SukkoPera/MyTrackr/pcb/MyTrackr.png

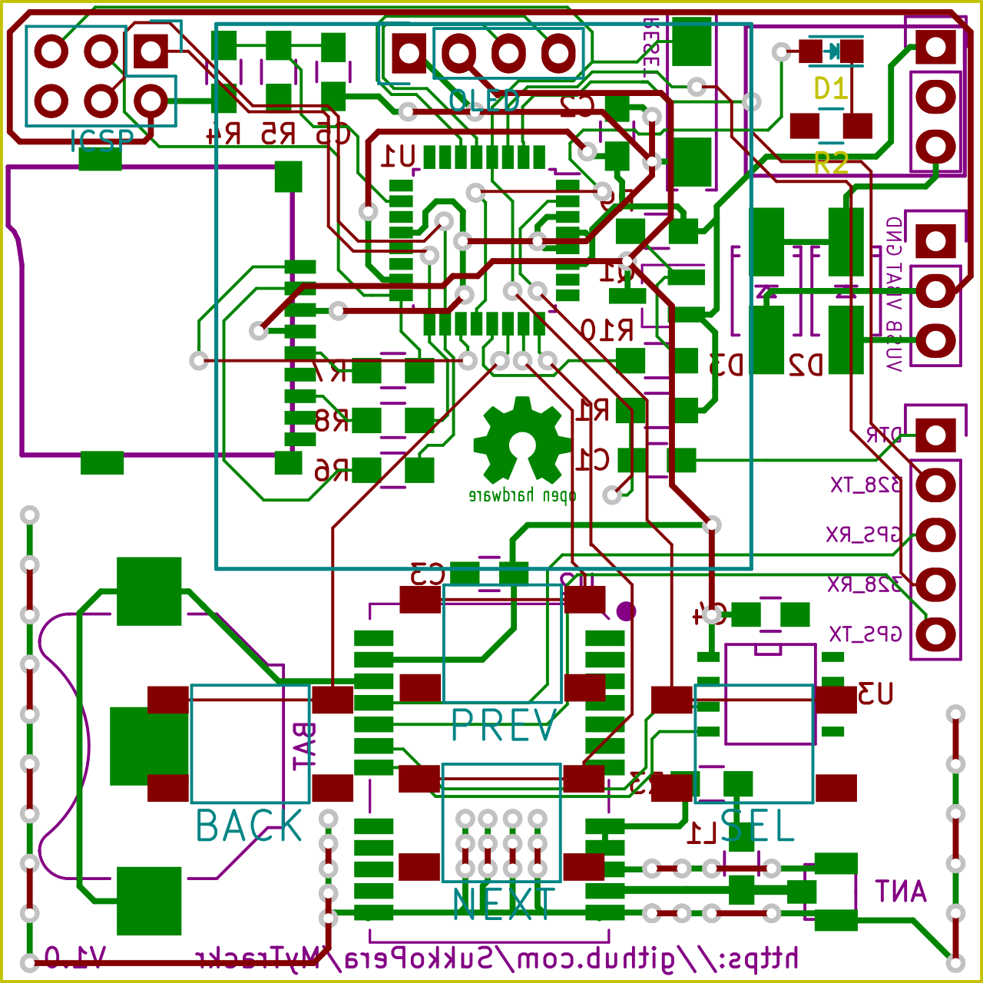
pcb/MyTrackr.png
