SukkoPera/MyTrackr/pcb/MyTrackr.pdf

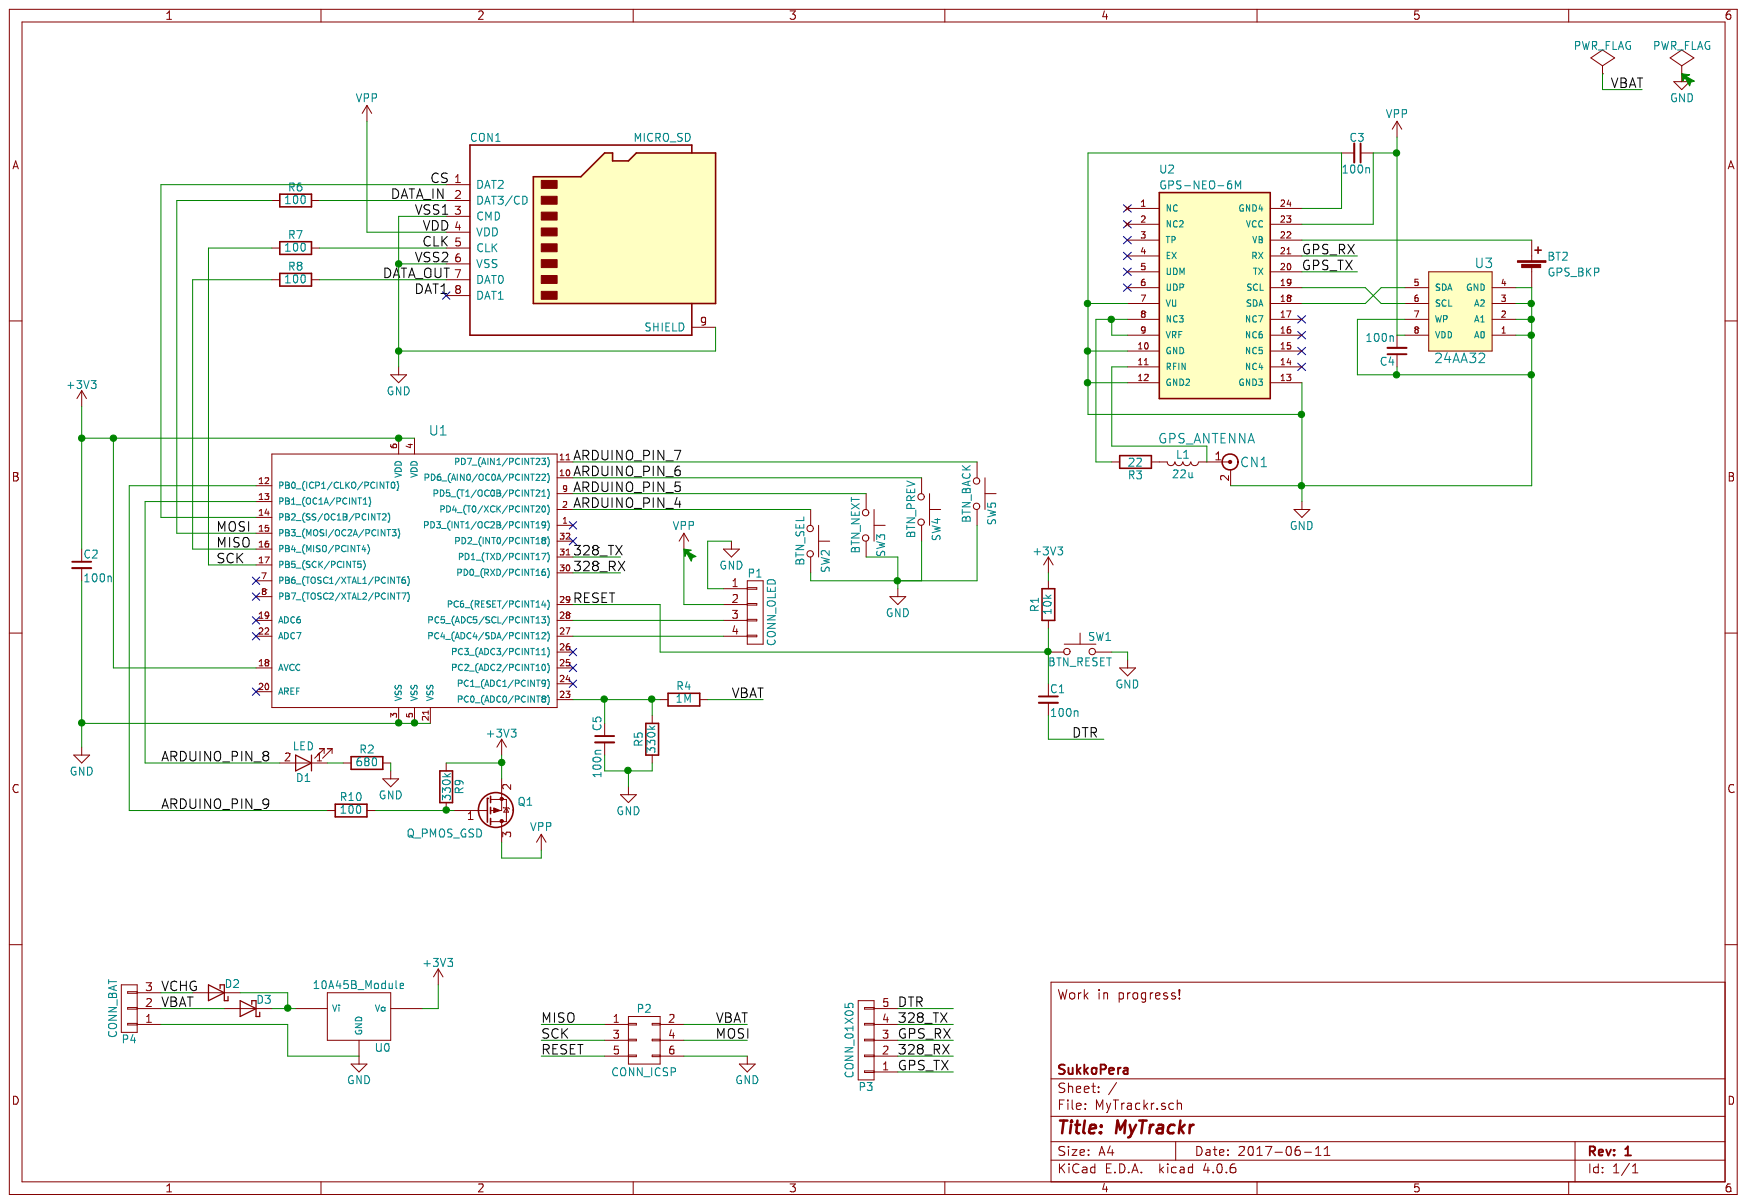
[picture p2: page 1]
