SukkoPera/MyTrackr/(list of files, drawings)

Other design files:
playground/ArdWinVaders/ArdWinVaders.fzz
