SukkoPera/MyTrackr/pcb/KiCad/MyTrackr.kicad_pcb

## KiCad design pcb/KiCad/MyTrackr.kicad_pcb (2017-09-08)

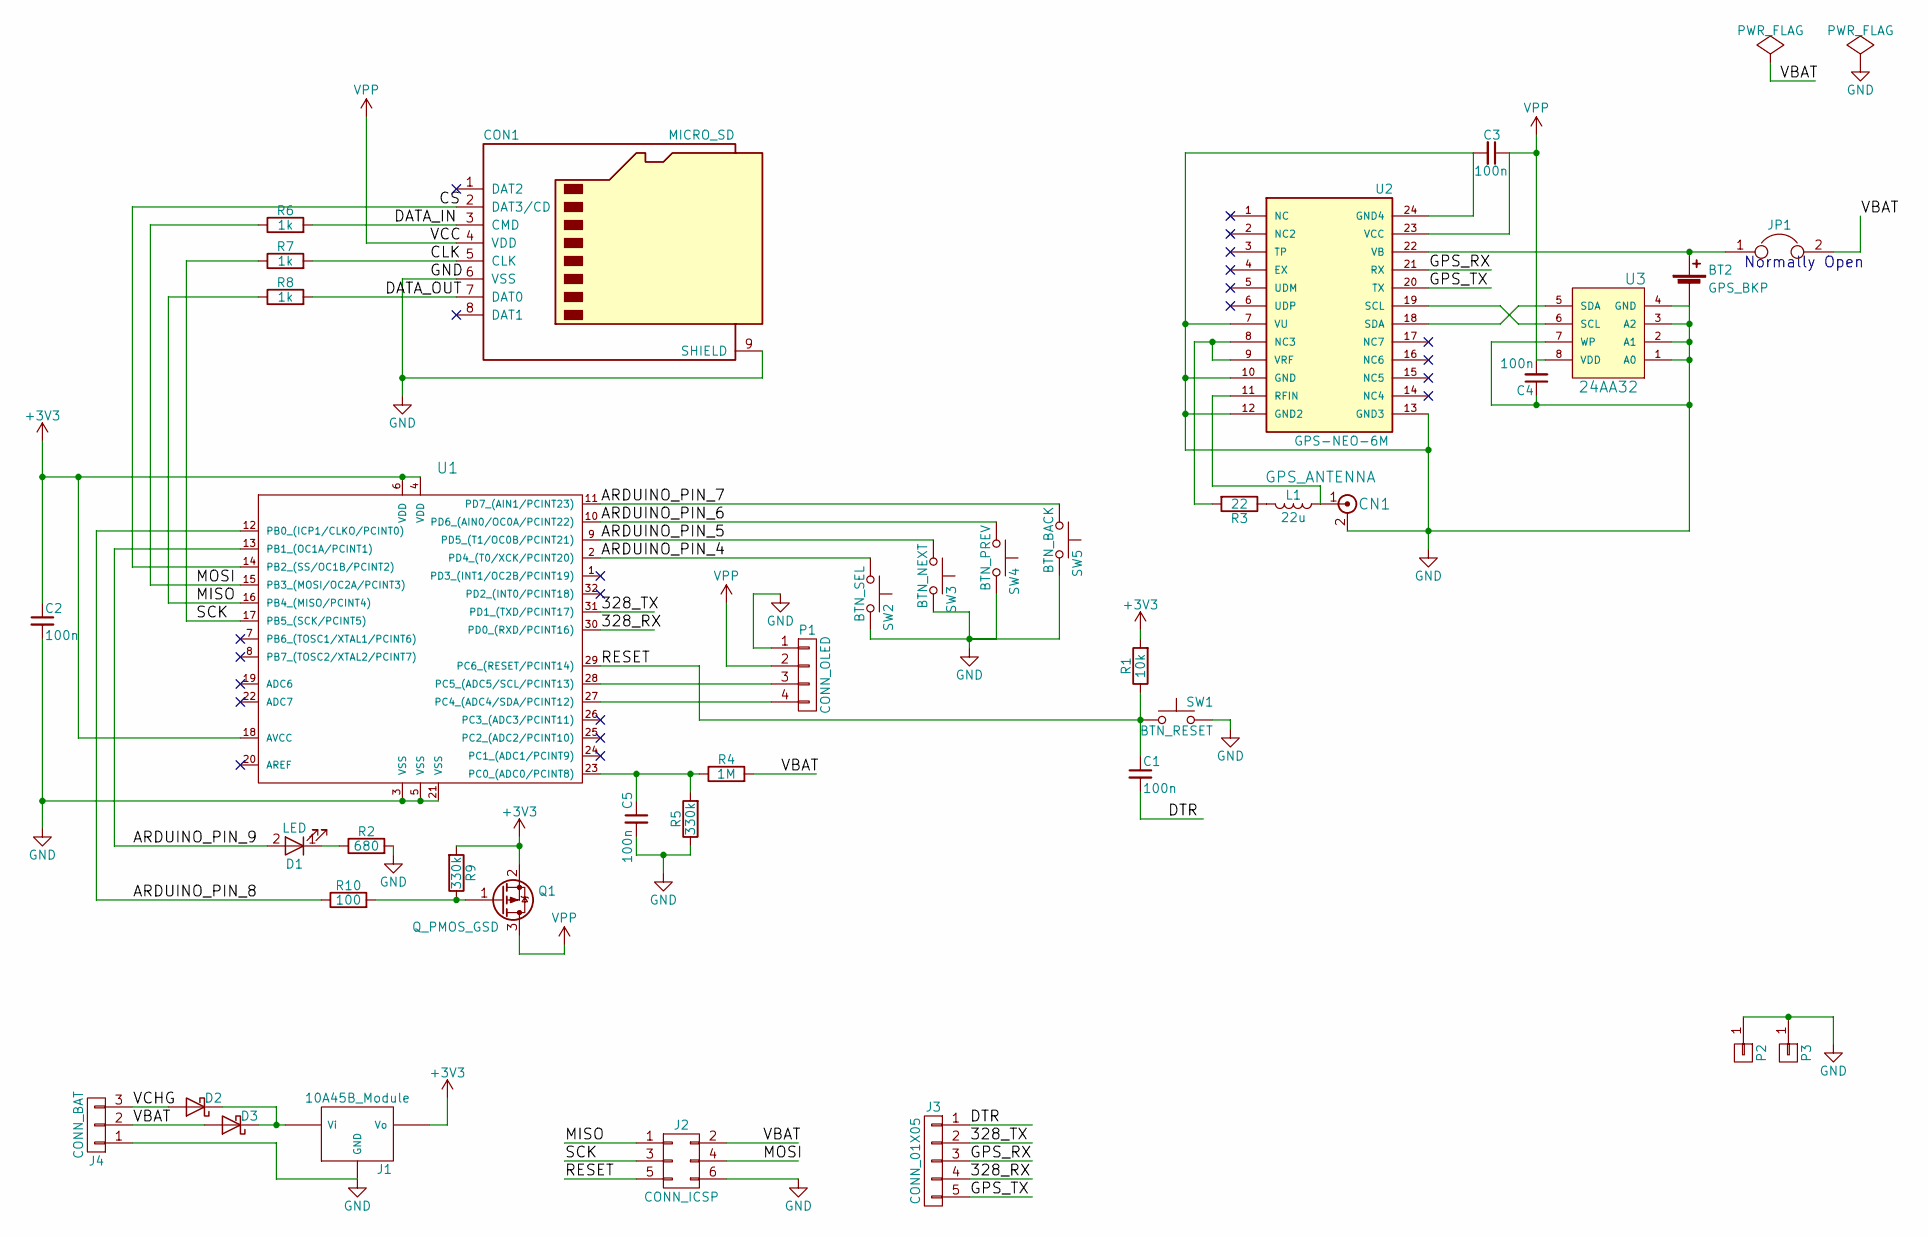
[picture p3: schematic MyTrackr.sch]

Parts:
BT2: GPS_BKP; Keystone_3000_1x12mm-CoinCell
C1, C2, C3, C4, C5: 100n; C_0805_HandSoldering
CN1: GPS_ANTENNA; CONN-RF-UFL
CON1: MICRO_SD; GCT-MEM2055-00-190-01-A
D1: LED; LED_0805
D2, D3: D_Schottky; SMA_Handsoldering
J1: 10A45B_Module; Pin_Header_Straight_1x03
J2: CONN_ICSP; Pin_Header_Straight_2x03
J3: CONN_01X05; Pin_Header_Straight_1x05
J4: CONN_BAT; Pin_Header_Straight_1x03
JP1: NO; R_0805_HandSoldering
L1: 22u; R_0805_HandSoldering
P1: CONN_OLED; Pin_Header_Straight_1x04
P2, P3: CONN_01X01; Screw_Hole_Plated_2mm
Q1: Q_PMOS_GSD; SOT-23_Handsoldering
R1: 10k; R_0805_HandSoldering
R2: 680; R_0805_HandSoldering
R3: 22; R_0805_HandSoldering
R4: 1M; R_0805_HandSoldering
R5, R9: 330k; R_0805_HandSoldering
R6, R7, R8: 1k; R_0805_HandSoldering
R10: 100; R_0805_HandSoldering
SW1: BTN_RESET; SW_SPST_REED_CT05-XXXX-J1
SW2: BTN_SEL; SW_TACT_SMD
SW3: BTN_NEXT; SW_TACT_SMD
SW4: BTN_PREV; SW_TACT_SMD
SW5: BTN_BACK; SW_TACT_SMD
U1: ATMEGA48_88_168_328P-32SMD; LQFP-32_7x7mm_Pitch0.8mm
U2: GPS-NEO-6M; GPS24P-SMD-1.1-16X12.2MM
U3: 24AA32; tssop-8

Connections:
+3V3: C2.1, J1.1 (Vo), Q1.2 (S), R1.2, R9.2, U1.4 (VDD), U1.6 (VDD), U1.18 (AVCC)
/328_RX: J3.4, U1.30 (PD0_(RXD/PCINT16))
/328_TX: J3.2, U1.31 (PD1_(TXD/PCINT17))
/ARDUINO_PIN_4: SW2.1, U1.2 (PD4_(T0/XCK/PCINT20))
/ARDUINO_PIN_5: SW3.1, U1.9 (PD5_(T1/OC0B/PCINT21))
/ARDUINO_PIN_6: SW4.1, U1.10 (PD6_(AIN0/OC0A/PCINT22))
/ARDUINO_PIN_7: SW5.1, U1.11 (PD7_(AIN1/PCINT23))
/ARDUINO_PIN_8: R10.1, U1.12 (PB0_(ICP1/CLKO/PCINT0))
/ARDUINO_PIN_9: D1.2 (A), U1.13 (PB1_(OC1A/PCINT1))
/CLK: CON1.5 (CLK), R7.2
/CS: CON1.2 (DAT3/CD), U1.14 (PB2_(SS/OC1B/PCINT2))
/DATA_IN: CON1.3 (CMD), R6.2
/DATA_OUT: CON1.7 (DAT0), R8.2
/DTR: C1.2, J3.1
/GPS_RX: J3.3, U2.21 (RX)
/GPS_TX: J3.5, U2.20 (TX)
/MISO: J2.1, R8.1, U1.16 (PB4_(MISO/PCINT4))
/MOSI: J2.4, R6.1, U1.15 (PB3_(MOSI/OC2A/PCINT3))
/RESET: C1.1, J2.5, R1.1, SW1.1, U1.29 (PC6_(RESET/PCINT14))
/SCK: J2.3, R7.1, U1.17 (PB5_(SCK/PCINT5))
/VBAT: D3.2 (A), J2.2, J4.2, JP1.2, R4.2
/VCHG: D2.2 (A), J4.3
GND: BT2.2 (-), C2.2, C3.2, C4.1, C5.2, CN1.2, CON1.6 (VSS), CON1.9 (SHIELD), J1.2 (GND), J2.6, J4.1, P1.1, P2.1, P3.1, R2.2, R5.1, SW1.2, SW2.2, SW3.2, SW4.2, SW5.2, U1.3 (VSS), U1.5 (VSS), U1.21 (VSS), U2.7 (VU), U2.10 (GND), U2.12 (GND2), U2.13 (GND3), U2.24 (GND4), U3.1 (A0), U3.2 (A1), U3.3 (A2), U3.4 (GND), U3.7 (WP)
unnamed: BT2.1 (+), JP1.1, U2.22 (VB)
unnamed: C5.1, R4.1, R5.2, U1.23 (PC0_(ADC0/PCINT8))
unnamed: CN1.1, L1.1, U2.11 (RFIN)
unnamed: D1.1 (K), R2.1
unnamed: D2.1 (K), D3.1 (K), J1.3 (Vi)
unnamed: L1.2, R3.1
unnamed: P1.3, U1.28 (PC5_(ADC5/SCL/PCINT13))
unnamed: P1.4, U1.27 (PC4_(ADC4/SDA/PCINT12))
unnamed: Q1.1 (G), R9.1, R10.2
unnamed: R3.2, U2.8 (NC3), U2.9 (VRF)
unnamed: U2.18 (SDA), U3.5 (SDA)
unnamed: U2.19 (SCL), U3.6 (SCL)
VPP: C3.1, C4.2, CON1.4 (VDD), P1.2, Q1.3 (D), U2.23 (VCC), U3.8 (VDD)

Notes on the sheet:
Normally Open

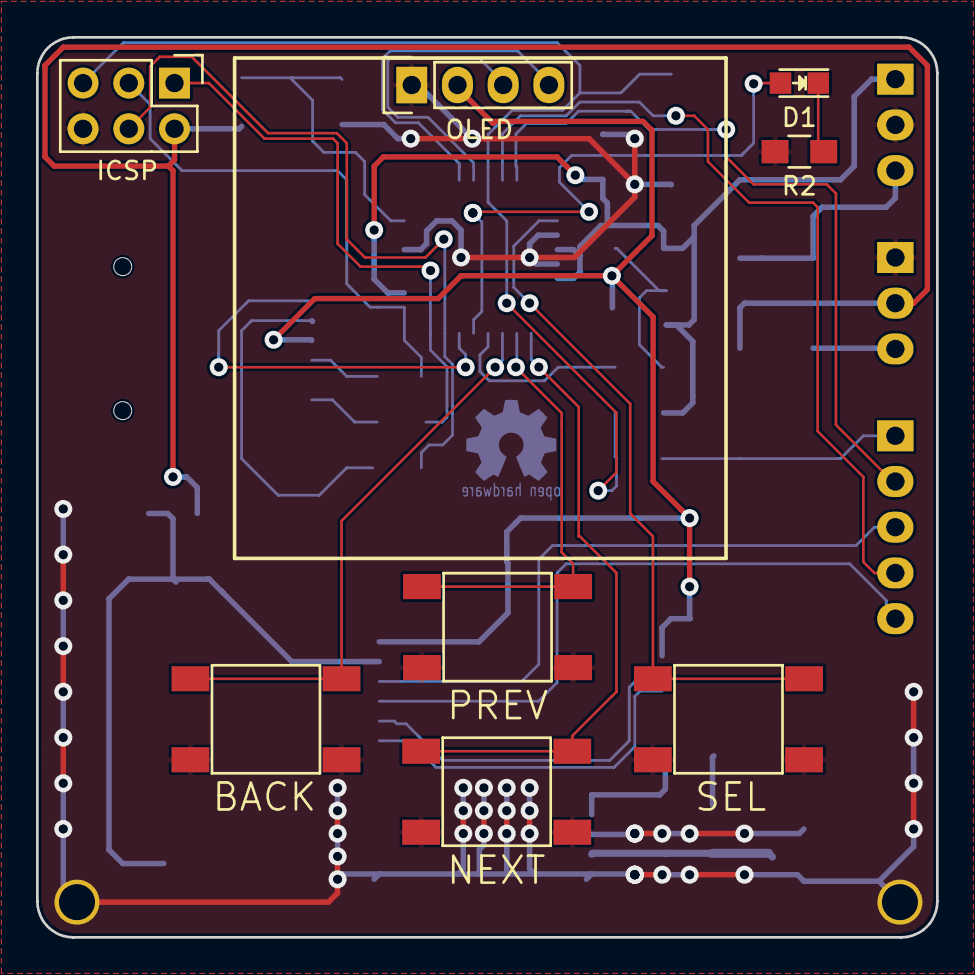
[picture p4: board MyTrackr.kicad_pcb from above]

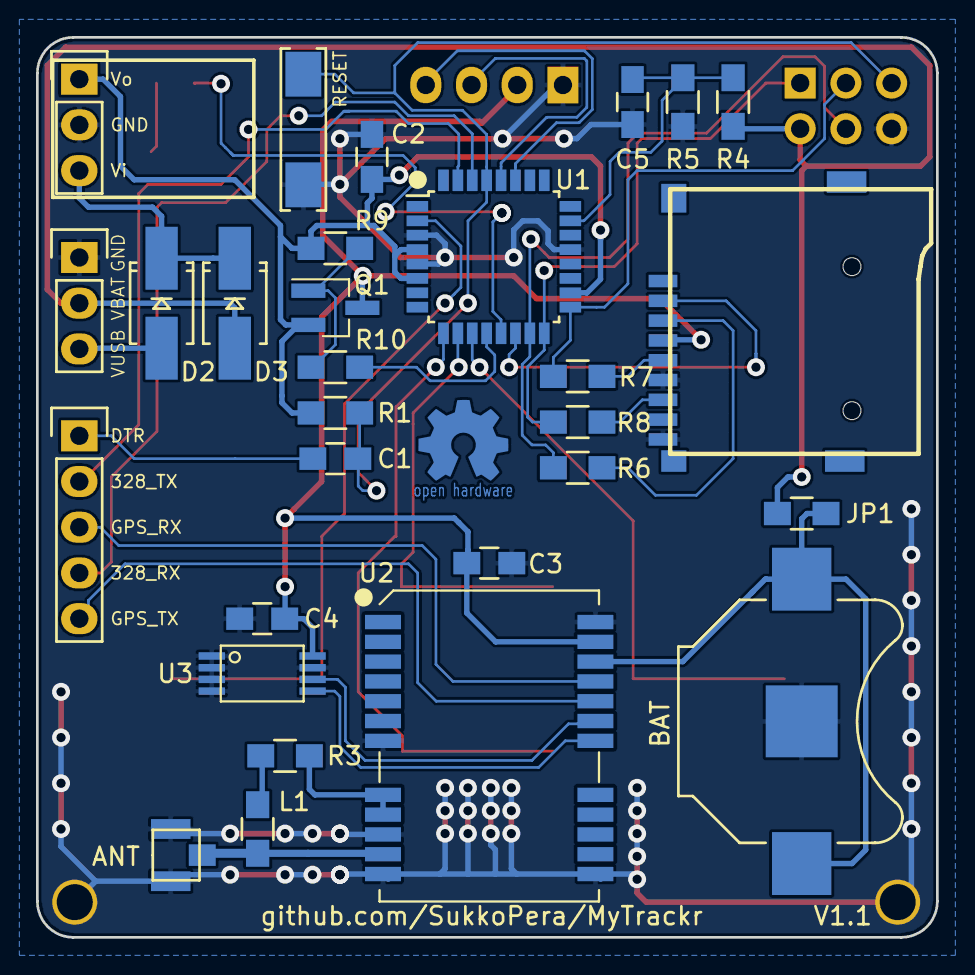
[picture p5: board MyTrackr.kicad_pcb from below]

Board: 2 copper layers, 50.0 x 50.0 mm, 39 parts (29 on the bottom side), 36 nets.
