SukkoPera/MyTrackr/menu.h

#include "MenuHandler.h"

MenuHandler menuHandler;

class SwitcherMenuItem: public StaticMenuItem {
private:
	Menu menu;

public:
	SwitcherMenuItem (PGM_P _name, const Menu& _m): StaticMenuItem (_name), menu (_m) {
	}

	void activate (void) override {
		menuHandler.setCur (menu);
	}
};

/******************************************************************************/

// Forward declarations
extern MenuItem * const topMenu[] PROGMEM, * const subMenuLogOpts[] PROGMEM, * const subMenuTimeOpts[] PROGMEM;

// Item to get back to main menu
const char mlBack[] PROGMEM = "Back";
SwitcherMenuItem lbtop (mlBack, topMenu);


/*******************************************************************************
 * Log Options Menu
 ******************************************************************************/

SwitcherMenuItem lb (mlBack, subMenuLogOpts);

class MenuItemLogFreq: public StaticMenuItem {
private:
	byte freq;

public:
	MenuItemLogFreq (PGM_P name, byte f): StaticMenuItem (name), freq (f) {
	}

	void activate () override {
		options.logFreq = freq;

		DPRINT (F("Log Frequency is now "));
		DPRINT (options.logFreq);
		DPRINTLN (F(" seconds"));

		lb.activate ();
	}

	bool isSelected (void) override {
		return options.logFreq == freq;
	}
};

#ifdef ENABLE_DISTANCE_MENU
class MenuItemLogDist: public StaticMenuItem {
private:
	int dist;

public:
	MenuItemLogDist (PGM_P name, int d): StaticMenuItem (name), dist (d) {
	}

	void activate () override {
		options.logDist = dist;

		DPRINT (F("Log Distance is now "));
		DPRINT (options.logDist);
		DPRINTLN (F(" meters"));

		lb.activate ();
	}

	bool isSelected (void) override {
		return options.logDist == dist;
	}
};
#endif

#ifdef ENABLE_ROTATION_MENU
class MenuItemLogRot: public StaticMenuItem {
private:
	LogRotation rot;

public:
	MenuItemLogRot (PGM_P name, LogRotation r): StaticMenuItem (name), rot (r) {
	}

	void activate () override {
		options.logRot = rot;

		DPRINT (F("Log Rotation is now "));
		DPRINTLN (options.logRot);

		lb.activate ();
	}

	bool isSelected (void) override {
		return options.logRot == rot;
	}
};
#endif

const char mlf1[] PROGMEM = "1 second";
MenuItemLogFreq lf1 (mlf1, 1);
const char mlf5[] PROGMEM = "5 seconds";
MenuItemLogFreq lf5 (mlf5, 5);
const char mlf10[] PROGMEM = "10 seconds";
MenuItemLogFreq lf10 (mlf10, 10);
const char mlf30[] PROGMEM = "30 seconds";
MenuItemLogFreq lf30 (mlf30, 30);
const char mlf60[] PROGMEM = "1 minute";
MenuItemLogFreq lf60 (mlf60, 60);
MenuItem * const subMenuLogFreq[] PROGMEM = {&lf1, &lf5, &lf10, &lf30, &lf60, &lb, NULL};

const char mlOff[] PROGMEM = "Off";
#ifdef ENABLE_DISTANCE_MENU
MenuItemLogDist ldOff (mlOff, 0);
const char ml10[] PROGMEM = "10 m";
MenuItemLogDist ld10 (ml10, 10);
const char ml100[] PROGMEM = "100 m";
MenuItemLogDist ld100 (ml100, 100);
const char ml250[] PROGMEM = "250 m";
MenuItemLogDist ld250 (ml250, 250);
const char ml1000[] PROGMEM = "1 km";
MenuItemLogDist ld1000 (ml1000, 1000);
MenuItem * const subMenuLogDist[] PROGMEM = {&ldOff, &ld10, &ld100, &ld250, &ld1000, &lb, NULL};
#endif

#ifdef ENABLE_ROTATION_MENU
MenuItemLogRot lrOff (mlOff, LOGROT_OFF);
const char mlH[] PROGMEM = "Hourly";
MenuItemLogRot lrH (mlH, LOGROT_HOURLY);
const char mlD[] PROGMEM = "Daily";
MenuItemLogRot lrD (mlD, LOGROT_DAILY);
const char mlW[] PROGMEM = "Weekly";
MenuItemLogRot lrW (mlW, LOGROT_WEEKLY);
const char mlM[] PROGMEM = "Monthly";
MenuItemLogRot lrM (mlM, LOGROT_MONTHLY);
MenuItem * const subMenuLogRot[] PROGMEM = {&lrOff, &lrH, &lrD, &lrW, &lrM, &lb, NULL};
#endif

const char mlFreq[] PROGMEM = "Frequency";
SwitcherMenuItem loFreq (mlFreq, subMenuLogFreq);
#ifdef ENABLE_DISTANCE_MENU
const char mlDist[] PROGMEM = "Distance";
SwitcherMenuItem loDist (mlDist, subMenuLogDist);
#endif
#ifdef ENABLE_ROTATION_MENU
const char mlRot[] PROGMEM = "Rotation";
SwitcherMenuItem loRot (mlRot, subMenuLogRot);
#endif
MenuItem * const subMenuLogOpts[] PROGMEM = {&loFreq,
#ifdef ENABLE_DISTANCE_MENU
	&loDist,
#endif
#ifdef ENABLE_ROTATION_MENU
	&loRot,
#endif
	&lbtop, NULL};


/*******************************************************************************
 * Time Options Menu
 ******************************************************************************/

SwitcherMenuItem ltb (mlBack, subMenuTimeOpts);

class MenuItemTimeOffset: public StaticMenuItem {
private:
	int8_t offset;

public:
	MenuItemTimeOffset (PGM_P name, int8_t o): StaticMenuItem (name), offset (o) {
	}

	void activate () override {
		options.utcOffset = offset;

		DPRINT (F("UTC offset is now "));
		DPRINT (options.utcOffset);
		DPRINTLN (F(" hours"));

		ltb.activate ();
	}

	bool isSelected (void) override {
		return options.utcOffset == offset;
	}
};

class MenuItemTimeDst: public StaticMenuItem {
private:
	DaylightSavingMode mode;

public:
	MenuItemTimeDst (PGM_P name, DaylightSavingMode m): StaticMenuItem (name), mode (m) {
	}

	void activate () override {
		options.dstMode = mode;

		DPRINT (F("DST mode is now "));
		DPRINTLN (options.dstMode);

		ltb.activate ();
	}

	bool isSelected (void) override {
		return options.dstMode == mode;
	}
};

const char mlAuto[] PROGMEM = "Auto";
MenuItemTimeDst da (mlAuto, DST_AUTO);
const char mlOn[] PROGMEM = "On";
MenuItemTimeDst don (mlOn, DST_ON);
MenuItemTimeDst doff (mlOff, DST_OFF);
MenuItem * const subMenuDstMode[] PROGMEM = {&da, &don, &doff, &ltb, NULL};

const char mlOm12[] PROGMEM = "-12";
MenuItemTimeOffset om12 (mlOm12, -12);
const char mlOm11[] PROGMEM = "-11";
MenuItemTimeOffset om11 (mlOm11, -11);
const char mlOm10[] PROGMEM = "-10";
MenuItemTimeOffset om10 (mlOm10, -10);
const char mlOm9[] PROGMEM = "-9";
MenuItemTimeOffset om9 (mlOm9, -9);
const char mlOm8[] PROGMEM = "-8";
MenuItemTimeOffset om8 (mlOm8, -8);
const char mlOm7[] PROGMEM = "-7";
MenuItemTimeOffset om7 (mlOm7, -7);
const char mlOm6[] PROGMEM = "-6";
MenuItemTimeOffset om6 (mlOm6, -6);
const char mlOm5[] PROGMEM = "-5";
MenuItemTimeOffset om5 (mlOm5, -5);
const char mlOm4[] PROGMEM = "-4";
MenuItemTimeOffset om4 (mlOm4, -4);
const char mlOm3[] PROGMEM = "-3";
MenuItemTimeOffset om3 (mlOm3, -3);
const char mlOm2[] PROGMEM = "-2";
MenuItemTimeOffset om2 (mlOm2, -2);
const char mlOm1[] PROGMEM = "-1";
MenuItemTimeOffset om1 (mlOm1, -1);
const char mlO0[] PROGMEM = "0";
MenuItemTimeOffset o0 (mlO0, 0);
const char mlOp1[] PROGMEM = "+1";
MenuItemTimeOffset op1 (mlOp1, +1);
const char mlOp2[] PROGMEM = "+2";
MenuItemTimeOffset op2 (mlOp2, +2);
const char mlOp3[] PROGMEM = "+3";
MenuItemTimeOffset op3 (mlOp3, +3);
const char mlOp4[] PROGMEM = "+4";
MenuItemTimeOffset op4 (mlOp4, +4);
const char mlOp5[] PROGMEM = "+5";
MenuItemTimeOffset op5 (mlOp5, +5);
const char mlOp6[] PROGMEM = "+6";
MenuItemTimeOffset op6 (mlOp6, +6);
const char mlOp7[] PROGMEM = "+7";
MenuItemTimeOffset op7 (mlOp7, +7);
const char mlOp8[] PROGMEM = "+8";
MenuItemTimeOffset op8 (mlOp8, +8);
const char mlOp9[] PROGMEM = "+9";
MenuItemTimeOffset op9 (mlOp9, +9);
const char mlOp10[] PROGMEM = "+10";
MenuItemTimeOffset op10 (mlOp10, +10);
const char mlOp11[] PROGMEM = "+11";
MenuItemTimeOffset op11 (mlOp11, +11);
const char mlOp12[] PROGMEM = "+12";
MenuItemTimeOffset op12 (mlOp12, +12);
MenuItem * const subMenuUtcOffset[] PROGMEM = {
	&om12, &om11, &om10, &om9, &om8, &om7, &om6, &om5, &om4, &om3, &om2, &om1,
	&o0,
	&op1, &op2, &op3, &op4, &op5, &op6, &op7, &op8, &op9, &op10, &op11, &op12,
	&ltb,
	NULL
};

const char mlUtcOffset[] PROGMEM = "UTC Offset";
SwitcherMenuItem toOff (mlUtcOffset, subMenuUtcOffset);
const char mlDst[] PROGMEM = "Daylight Saving";
SwitcherMenuItem toDst (mlDst, subMenuDstMode);
MenuItem * const subMenuTimeOpts[] PROGMEM = {&toOff, &toDst, &lbtop, NULL};


/*******************************************************************************
 * Backlight Timeout Menu
 ******************************************************************************/

#ifdef ENABLE_BACKLIGHT_MENU
class MenuItemBacklight: public StaticMenuItem {
private:
	byte interval;

public:
	MenuItemBacklight (PGM_P name, byte s): StaticMenuItem (name), interval (s) {
	}

	void activate () override {
		options.backlightTimeout = interval;

		DPRINT (F("Backlight Timeout is now "));
		DPRINT (options.backlightTimeout);
		DPRINTLN (F(" seconds"));

		lbtop.activate ();
	}

	bool isSelected (void) override {
		return options.backlightTimeout == interval;
	}
};

const char mblOn[] PROGMEM = "Always On";
MenuItemBacklight blOn (mblOn, 0);
MenuItemBacklight bl5 (mlf5, 5);
const char mbl15[] PROGMEM = "15 seconds";
MenuItemBacklight bl15 (mbl15, 15);
MenuItemBacklight bl30 (mlf30, 30);
MenuItemBacklight bl60 (mlf60, 60);
MenuItem * const subMenuBacklight[] PROGMEM = {&blOn, &bl5, &bl15, &bl30, &bl60, &lbtop, NULL};
#endif


/*******************************************************************************
 * Main Menu
 ******************************************************************************/

class StartStopMenuItem: public MenuItem {
public:
	FlashString getName (void) const override {
		if (logEnabled)
			return F("Stop");
		else
			return F("Start");
	}

	void activate (void) override {
		if (!logEnabled && sdAvailable) {
			logEnabled = true;
		} else {
			logEnabled = false;
		}

		DPRINT (F("Logging is now "));
		DPRINTLN (logEnabled ? F("ON") : F("OFF"));
	}
};

class ExitMenuItem: public StaticMenuItem {
public:
	ExitMenuItem (): StaticMenuItem (PSTR("Exit")) {
	}

	void activate (void) override {
		// Save data to EEPROM
		EEPROM.put (EEPROM_DATA_OFFSET, options);
		EEPROM.put (EEPROM_DATA_OFFSET + sizeof (options), EEPROM_GOOD_SIGNATURE);
		menuHandler.hide ();
	}
};

#ifdef ENABLE_SOFT_POWEROFF
class PowerOffMenuItem: public StaticMenuItem {
public:
	PowerOffMenuItem (): StaticMenuItem (PSTR("Power Off")) {
	}

	void activate (void) override {
		powerOff ();
	}
};
#endif

StartStopMenuItem ss;
const char mlLogOpts[] PROGMEM = "Logging";
SwitcherMenuItem lo (mlLogOpts, subMenuLogOpts);
const char mlTimeOpts[] PROGMEM = "Time";
SwitcherMenuItem to (mlTimeOpts, subMenuTimeOpts);
#ifdef ENABLE_BACKLIGHT_MENU
const char mlBl[] PROGMEM = "Backlight";
SwitcherMenuItem bl (mlBl, subMenuBacklight);
#endif
ExitMenuItem ex;
#ifdef ENABLE_SOFT_POWEROFF
PowerOffMenuItem miPowerOff;
#endif
MenuItem * const topMenu[] PROGMEM = {&ss, &lo, &to,
#ifdef ENABLE_BACKLIGHT_MENU
	&bl,
#endif
#ifdef ENABLE_SOFT_POWEROFF
	&miPowerOff,
#endif
	&ex,
	NULL
};
