SukkoPera/MyTrackr/icons.h

// Height of header space
#define HEADER_HEIGHT 16

#define sat_width 16
#define sat_height 16
const unsigned char sat_bits[] PROGMEM = {
	0x08, 0x00, 0x14, 0x00, 0x22, 0x00, 0x41, 0x00, 0x82, 0x02, 0x84, 0x07,
	0xc8, 0x0f, 0xf0, 0x07, 0xe0, 0x0f, 0xf0, 0x13, 0xe0, 0x21, 0x40, 0x41,
	0x00, 0x82, 0x00, 0x44, 0x00, 0x28, 0x00, 0x10
};

#define microsd_width 16
#define microsd_height 16
const unsigned char microsd_bits[] PROGMEM = {
	0x00, 0x00, 0x00, 0x00, 0xf0, 0x1f, 0x50, 0x15, 0x50, 0x15, 0x50, 0x15,
	0xf0, 0x1f, 0xf0, 0x1f, 0xf8, 0x1f, 0xf8, 0x1f, 0xf8, 0x1f, 0xf8, 0x1f,
	0xf8, 0x1f, 0xf8, 0x1f, 0x00, 0x00, 0x00, 0x00
};

#define padlock_width 16
#define padlock_height 16
const unsigned char padlock_bits[] PROGMEM = {
   0xc0, 0x03, 0x60, 0x06, 0x30, 0x0c, 0x10, 0x08, 0x10, 0x08, 0x10, 0x08,
   0xf8, 0x1f, 0x0c, 0x30, 0x04, 0x20, 0xc4, 0x23, 0xc4, 0x23, 0x84, 0x21,
   0x84, 0x21, 0x04, 0x20, 0x0c, 0x30, 0xf8, 0x1f
};


// Battery icon size (this is drawn by hand)
#define BAT_WIDTH 16
#define BAT_HEIGHT 8
#define BAT_TIP 2
