SukkoPera/MyTrackr/(commit log)

2016-06-12 Blink sat & SD icon for relevant failures
    [MyTracker.ino]
2016-06-13 Fix altitude & some source reorganization
    [CSVWriter.cpp, CSVWriter.h, MyTracker.ino, config.h, debug.h]
2016-06-16 Fix trailing CR in log header with SD disabled
    [CSVWriter.cpp]
2016-06-19 Simplify key handling. Also support a PREV button, if available.
2016-06-25 Only consider fix valid if number of sats > 0
    [MyTracker.ino]
2016-07-10 Measure and display battery level
2016-10-09 Turn screen off to save power
2016-10-09 Revamp battery charge handling Work in progress...
    [battery.csv, logbat.csv, logbat5.csv]
2016-10-09 Remove useless battery logs
    [logbat.csv, logbat5.csv]
2017-05-07 Add "Alive LED"
2017-05-07 Reset current menu item when menu is opened
    [MenuHandler.h]
2017-05-08 Implement $GPGLL and fix checksum calculation
    [sim.py]
2017-05-08 Compile fix for when both ENABLE_SD_FATLIB and ENABLE_SD_FAT16 are disabled
    [CSVWriter.cpp]
2017-05-17 Add first version of PCB
2017-05-17 Add voltage divider for battery
2017-05-18 Add resistors on SPI lines, add cap on A0, add pull-down on MOSFET
2017-06-11 Update schematics
2017-06-11 Fix MOSFET orientation, add resistor on gate and change pull-up value
2017-08-03 Add prototype PCB design files
    [MyTrackr-B.Cu.gbr, MyTrackr-B.Mask.gbr, MyTrackr-B.SilkS.gbr, MyTrackr-Edge.Cuts.gbr, MyTrackr-F.Cu.gbr, MyTrackr-F.Mask.gbr, MyTrackr-F.SilkS.gbr, MyTrackr-NPTH.drl]
2017-09-06 Corrections and tweaks after first prototype
    [MyTrackr.kicad_pcb, MyTrackr.sch]
2017-09-06 Expand zones
    [MyTrackr.kicad_pcb]
2017-09-08 Add screw holes, smooth corners and more
    [MyTrackr.kicad_pcb, MyTrackr.sch]
2017-09-08 Add screw hole footprint
2017-09-10 Add board package
2018-03-26 Fix platform/board names
2018-03-26 Fix key pins according to PCB
    [config.h]
2018-03-26 Implement soft power off
2018-03-26 Add u8g.begin() just in case
2018-03-26 Use led to communicate status 1 blink = Got position, battery OK 2 blinks = No position, battery OK 3 blinks = Battery low
2018-03-27 Implement Back button in menus
2018-04-20 Add playground ;)
    [ArdWinVaders.fzz]
2018-08-26 Don't turn on/Auto turn off on critically low battery
