SukkoPera/MyTrackr/(notices)

Notices in the files:
playground/TinyTetris/TinyTetris.ino:
Copyright (C) 2016 Anthony Russell
Buttons.h:
Copyright (C) 2016 by SukkoPera <software@sukkology.net>
LeoBraille is free software: you can redistribute it and/or modify
it under the terms of the GNU General Public License as published by
the Free Software Foundation, either version 3 of the License, or
(at your option) any later version.
